tiagotvt/HomeControl/Tiago/teste.jpg

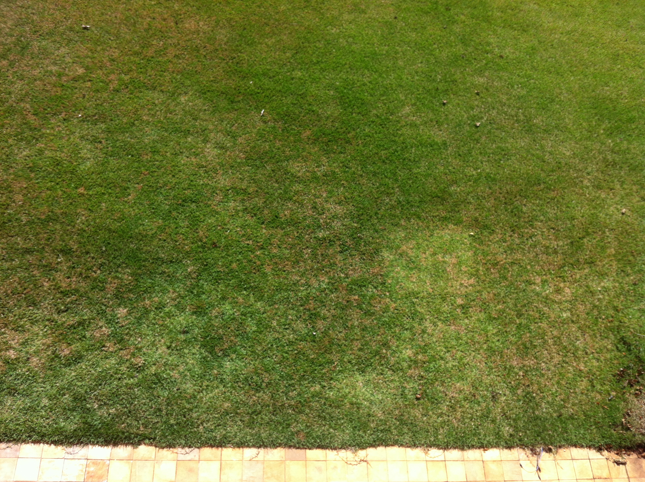
Tiago/teste.jpg
