tiagotvt/HomeControl/Manuel para Monografia.JPG

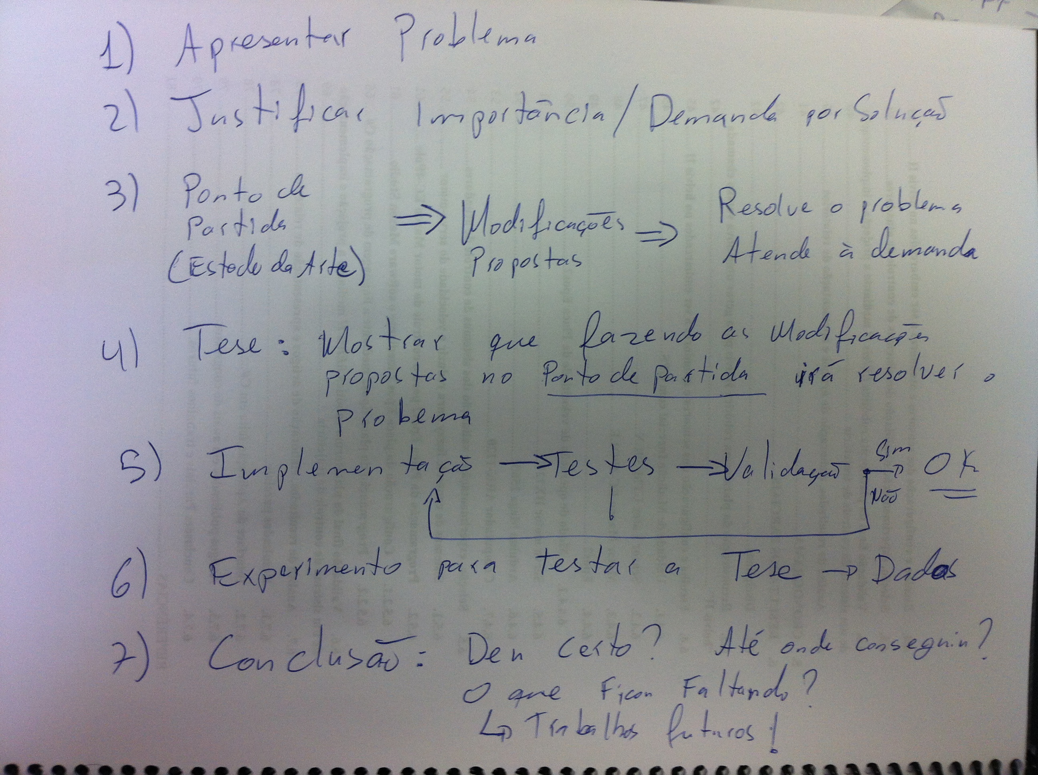
Manuel para Monografia.JPG
