tiagotvt/HomeControl/README.md

# HomeControl
Smart home control and automation systems
