tiagotvt/HomeControl/Tiago/3Dparts/readme

All the 3D files used in this project.
Software used: Solid Edge
Printer: Cube
