tiagotvt/HomeControl/Tiago/Interface/Readme

All files used in the Raspberry Pi's interface
