tiagotvt/HomeControl/(commit log)

2015-05-18 Manuel de como fazer uma monografia - Da introducao a conclusao
2015-09-14 Included raspberry code
2015-10-11 Fixed bugs with connect function and increased tolerance to failure
    The connect function is now prepared to work in the following scenarios:
    -Modules connect immediately
    -Modules don't connect at all
    -Modules connect after a random amount of time
    -Module does not receive the connect command properly
    In the case of having the connection occur after a random amount of
    time, the function is able to immediately detect and report the
    connection.
    [Arduino_01.1.ino, Arduino_01.ino]
2015-10-13 Added disconnect function to arduino code
    Arduino is now able to disconnect its module on command.
    The function is prepared to work with the following scenarios:
    - Module was connected and disconnection is performed successfully.
    - Module was already disconnected.
    Function was tested and verified to work properly with the connect
    function.
2015-10-16 Added connect funtion for the Raspberry
    Connect function has been ported to C code and now runs on the
    Raspberry.
    Functionality is the same as the arduino version, with two exceptions:
    -Only tries to connect once (10s) per run of the executable
    -Output is only through printf, no return
2015-10-22 Packet structure for comms established - send and receive functions added
    Any information sent is now structured in a packet <mac sender / mac
    receiver / data / checksum>
    getstr function is for getting messages from the module (OK+CONN, etc)
    getpkt is for receiving a packet from another arduino/pi
    send is for packaging and sendind any data to another module
    Also added disconnect function for the Raspberry
2015-11-14 Beta stage for Arduino and Raspberry functions
    All functions have now been implemented and tested for basic
    functionality.
    Final version should maintain current structure and fix any bugs that
    surface during testing.
    [Arduino_01.ino, packet.h]
2015-11-28 Final release
    Functions have been tested and debugged.
    Bounce function added. It is called internally by getpkt when IDS is not
    the same as the local ID and transmits the message to the proper IDS,
    then gets the response back to the original requester.
    Simple rain/window code implemented for testing purposes. Can be found
    under the sensorAgua and Janela files.
